poommyroboticcamera-netizen/DATA-Logging-Dashboard-esp32/README.md

# ESP32 Data Logging Dashboard · v2.0

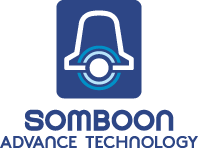
[picture p1: dashboard/assets/somboon-logo.png]
Somboon Advance Technology


แดชบอร์ดสำหรับดูค่าเซนเซอร์และบันทึกข้อมูลลง SD card/CSV ผ่าน ESP32 ใช้ Wi‑Fi 2.4 GHz เปิดดูจากโทรศัพท์หรือคอมพิวเตอร์ในเครือข่ายเดียวกันได้ หน้าเว็บฝังอยู่ในเฟิร์มแวร์: อัปโหลดครั้งเดียวได้ทั้งโปรแกรมและหน้าเว็บ

[ลองหน้าเว็บตัวอย่าง](https://poommyroboticcamera-netizen.github.io/DATA-Logging-Dashboard-esp32/) · [วิธีติดตั้ง](#เริ่มใช้งาน) · [วิธีบันทึกข้อมูล](#บันทึกข้อมูล) · [แก้ปัญหาเบื้องต้น](#แก้ปัญหาเบื้องต้น)

> **หน้าเว็บตัวอย่างบน GitHub Pages ใช้ข้อมูลจำลอง** ปุ่มต่าง ๆ ในหน้านั้นไม่สั่ง ESP32 จริง หากจะตั้งค่า Wi‑Fi หรือบันทึกจากบอร์ด ให้เปิดหน้าเว็บจาก IP ของ ESP32 หรือจุดตั้งค่า `192.168.4.1`

## มีอะไรใน v2.0

- ดู INA226 สามช่อง, DHT22, DS18B20 สี่ตัว, IMU, RTC, Encoder และสถานะการบันทึกแบบสด
- เริ่ม/หยุดบันทึกจากหน้าเว็บหรือปุ่มบนบอร์ด ตั้งช่วงบันทึกได้ **100–60,000 ms** (ค่าเริ่มต้น **1,000 ms**)
- บันทึก CSV ลง SD card ขณะกด START เท่านั้น; เมื่อกด STOP ระบบเขียนข้อมูลที่ค้างให้เสร็จและปิด SD
- ตั้ง Wi‑Fi ใหม่จากหน้าเว็บได้ แม้ยังต่อเราเตอร์เดิมไม่ได้ เพราะ ESP32 เปิดจุดตั้งค่า Wi‑Fi ของตัวเอง
- อ่านสัญญาณ **Z ของ Encoder ที่ GPIO33**; หน้าเว็บแสดง **WHEEL RPM (รอบล้อ)** ซึ่งคำนวณจากอัตราทดลูกกลิ้ง
- มีไฟ GA0–GA3 บอกสถานะการเขียน SD และมีบรรทัด `[ENC Z]` ทาง Serial สำหรับตรวจสาย Encoder

รุ่นก่อนหน้าอยู่ที่แท็ก [v1.0](https://github.com/poommyroboticcamera-netizen/DATA-Logging-Dashboard-esp32/tree/v1.0) ส่วนรุ่นนี้อยู่ที่ [v2.0](https://github.com/poommyroboticcamera-netizen/DATA-Logging-Dashboard-esp32/tree/v2.0) ทั้งสองรุ่นไม่มี CAN bus

## เริ่มใช้งาน

ต้องมีบอร์ด ESP32, สาย USB สำหรับอัปโหลด, [VS Code + PlatformIO](https://platformio.org/install/ide?install=vscode) หรือ PlatformIO CLI และการต่อเซนเซอร์ตาม [ตารางขา](#ขาและอุปกรณ์หลัก) หากจะบันทึกลง SD ให้ใส่การ์ด **FAT16/FAT32** ก่อนเริ่ม (exFAT ใช้ไม่ได้)

1. ดาวน์โหลดหรือโคลนโปรเจกต์ แล้วสร้างไฟล์ Wi‑Fi ส่วนตัวจากไฟล์ตัวอย่าง:

   ```powershell
   git clone https://github.com/poommyroboticcamera-netizen/DATA-Logging-Dashboard-esp32.git
   cd DATA-Logging-Dashboard-esp32
   Copy-Item include/wifi_config.example.h include/wifi_config.h
   ```

   บน macOS/Linux ใช้ `cp include/wifi_config.example.h include/wifi_config.h` แทน `Copy-Item` จะใส่ชื่อ/รหัส Wi‑Fi 2.4 GHz ใน `include/wifi_config.h` ตอนนี้ก็ได้ หรือปล่อยข้อความตัวอย่างไว้แล้วตั้งค่าผ่านจุดตั้งค่าของ ESP32 หลังอัปโหลด ไฟล์ `wifi_config.h` ถูก Git เพิกเฉยและไม่ควรพุชขึ้นสาธารณะ

2. ต่อบอร์ดผ่าน USB เลือกพอร์ตให้ถูก แล้วกด **Upload** ใน PlatformIO หรือใช้คำสั่ง:

   ```sh
   pio run -e esp32dev -t upload
   pio device monitor -b 115200
   ```

   ปิด Serial Monitor อื่นก่อนอัปโหลด หลังอัปโหลดไม่ต้องคัดลอกไฟล์ HTML ลง SD อีก

3. เปิดแดชบอร์ดด้วยวิธีใดวิธีหนึ่ง:

   - **ผ่านเราเตอร์:** ต่อโทรศัพท์/คอมกับ Wi‑Fi เดียวกัน แล้วเปิด IP ที่บอร์ดแสดงทาง Serial เช่น `http://192.168.1.50/`
   - **ผ่านจุดตั้งค่าของ ESP32:** ต่อ Wi‑Fi ชื่อ `ESP192.168.4.1` รหัส `88888888` แล้วเปิด `http://192.168.4.1/` หากบอร์ดต่อเราเตอร์ได้แล้ว ชื่อจุดตั้งค่าอาจเปลี่ยนเป็น `ESP` ตามด้วย IP ที่เราเตอร์แจก เช่น `ESP192.168.1.50`

4. ต้องการเปลี่ยนเราเตอร์ให้กดเมนู **ตั้งค่า Wi‑Fi** ใส่ SSID/รหัสผ่านของเครือข่าย **2.4 GHz** แล้วกด **บันทึกและเชื่อมต่อใหม่** บอร์ดจะรีสตาร์ต; หลังจากนั้นเปิด IP ใหม่หรือกลับเข้าผ่านจุดตั้งค่า

> เมื่อเชื่อมกับจุดตั้งค่าของ ESP32 โทรศัพท์อาจแจ้งว่า “ไม่มีอินเทอร์เน็ต” ให้คงการเชื่อมต่อนี้ไว้เพื่อเปิด `192.168.4.1` ถ้าหน้าเว็บหลังอัปโหลดดูเป็นรุ่นเก่า ให้รีเฟรชแบบไม่ใช้แคช (`Ctrl+F5`)

## บันทึกข้อมูล

1. ตรวจว่าหน้าเว็บแสดงค่าปัจจุบันและใส่ SD card แบบ FAT16/FAT32 แล้ว ตั้ง **ช่วงเวลาบันทึก** ตามต้องการ; ค่าเริ่มต้น 1,000 ms และบอร์ดจำค่าที่ตั้งไว้ (บอร์ดจะตรวจพบการ์ดจริงเมื่อกดเริ่มเท่านั้น)
2. กด **เริ่มบันทึก** บนเว็บหรือปุ่ม START บนบอร์ด บอร์ดจะสร้างรอบบันทึกใหม่และเริ่มเขียน CSV ลง SD
3. กด **หยุดบันทึก** บนเว็บหรือปุ่ม STOP รอให้บอร์ดเขียนแถวที่ค้างและปิด SD ก่อนถอดการ์ด
4. ไฟล์บน SD อยู่ในโฟลเดอร์ `/logs/` เช่น `log_00001.csv` ถ้าถอดการ์ดหลังปิด SD แล้วจึงนำไฟล์ไปเปิดบนคอมได้ หน้า **Logs** แสดงเฉพาะสำเนา CSV ที่เบราว์เซอร์เก็บไว้และให้ดาวน์โหลด/ลบสำเนานั้น ไม่ได้ลบไฟล์บน SD

เมื่อไม่ได้บันทึก บอร์ดยังแสดงค่าปัจจุบันแต่ไม่เปิดอ่าน/เขียน SD การตั้งช่วงเวลา 100 ms ไม่ได้ทำให้เซนเซอร์ทุกตัวอ่านใหม่ทุก 100 ms; ค่าใดอัปเดตช้ากว่าจะใช้ค่าล่าสุดพร้อมตัวบอกอายุข้อมูล

### ไฟ GA0–GA3 หมายถึงอะไร

| สถานะ | ไฟ GA |
|---|---|
| ระบบเริ่มต้น หรือเริ่มบันทึกแต่ SD ยังไม่เขียนแถวแรก | ติดทั้ง 4 ดวง |
| SD เขียนแถวแรกสำเร็จและกำลังบันทึก | ไฟวิ่ง GA3 → GA0 ตามช่วงเวลาบันทึก |
| กดหยุดและกำลังรอ SD ปิด | ติดทั้ง 4 ดวง |
| หยุดบันทึกและ SD ปิดเรียบร้อย | ดับทั้ง 4 ดวง |
| SD เขียนผิดพลาด หรือหลังรีเซตที่ไม่ใช่การเปิดไฟใหม่ | ติดทั้ง 4 ดวงเพื่อเตือน |

ไฟเตือนต้องอาศัย MCP23017 และไฟเลี้ยงของมัน หากอุปกรณ์นี้หรือ I²C ใช้งานไม่ได้ ระบบไม่สามารถรับประกันสถานะไฟได้

## เข้าใจค่า Encoder และ CSV

- สายสัญญาณ **Z → GPIO33**, GND ต้องร่วมกัน และสัญญาณที่เข้าขา ESP32 ต้องไม่เกิน **3.3 V** ถ้า Encoder ส่ง 5 V ต้องแปลงระดับก่อน
- ค่าเริ่มต้นสมมติว่า Z ให้ **1 พัลส์ต่อ 1 รอบ Encoder** โปรดตรวจสเปก Encoder ของจริง ระบบไม่อ่าน A/B จึงไม่รู้ทิศหมุน
- ลูกกลิ้ง Encoder เส้นผ่านศูนย์กลาง **43 mm** สัมผัสล้อ **63 mm** ดังนั้น `RPM ล้อ = RPM Encoder × 43/63` เมื่อไม่ลื่น การ์ด **WHEEL RPM** บนเว็บใช้ค่านี้ ไม่ใช่ค่า PWM ของมอเตอร์
- ใน CSV คอลัมน์ `RPMencoder` และ `shaft_rpm` คือรอบแกน Encoder; `wheel_rpm` คือรอบล้อที่คำนวณแล้ว หากลูกกลิ้งลื่น ตัวเลขรอบล้อ/ความเร็วจะคลาดเคลื่อน
- INA226: **Battery 0x44 → Vbat/Ibat**, **Rotary 0x45 → Vrotary/Irotary**, **Camera 0x40 → Vcamera/Icamera**; `Iwheel = Ibat - Irotary - Icamera` ค่าเริ่มต้น Rshunt ของแต่ละช่องคือ 1 mΩ และควรตั้งให้ตรงกับฮาร์ดแวร์จริง
- ไฟล์ CSV ยังมีเวลา RTC, อุณหภูมิ, IMU, สถานะความถูกต้อง/อายุข้อมูลของเซนเซอร์, จำนวนพัลส์ และช่วงเวลาบันทึก เริ่มไฟล์ใหม่ `sequence` จะเริ่มนับใหม่

สัญญาณ Z ที่ 1 พัลส์/รอบของลูกกลิ้ง 43 mm มีระยะประมาณ 135 mm ต่อพัลส์ จึงเหมาะกับการอ่านรอบมากกว่าระยะทางละเอียด และต้องได้อย่างน้อยสองพัลส์ก่อนประมาณ RPM ครั้งแรก

## ขาและอุปกรณ์หลัก

| อุปกรณ์ | ขา ESP32 / I²C |
|---|---|
| I²C SDA / SCL | GPIO21 / GPIO22 |
| INA226 Camera / Rotary / Battery | `0x40` / `0x45` / `0x44` |
| IMU MPU6050/MPU6500 · RTC MCP7940N · MCP23017 | `0x68` หรือ `0x69` · `0x6F` · `0x27` |
| Encoder Z | GPIO33 |
| DHT22 | GPIO4 |
| DS18B20 1–4 | GPIO27 / 16 / 13 / 14 (สาย DATA แยกกัน) |
| SD CS / SCK / MISO / MOSI | GPIO5 / 18 / 19 / 23 |
| ปุ่ม START / STOP | GPIO36 / GPIO39, active LOW, ต้องมี pull-up ภายนอก |
| ไฟ Debug | GPIO2 |

ตรวจ [เอกสารฮาร์ดแวร์](hardware/README.md) และลายวงจรของบอร์ดจริงก่อนต่อไฟ รุ่น schematic เก่าบางฉบับระบุ START เป็น GPIO34 แต่ค่าเริ่มต้นเฟิร์มแวร์ v2.0 ใช้ GPIO36

## แก้ปัญหาเบื้องต้น

| อาการ | จุดที่ควรตรวจ |
|---|---|
| ไม่พบ Wi‑Fi ของ ESP32 | ตรวจว่าอัปโหลด v2.0 แล้ว, ไฟเลี้ยงและ Serial 115200; ชื่อ AP อาจเปลี่ยนจาก `ESP192.168.4.1` เป็น `ESP` ตามด้วย IP ของบอร์ด |
| กดบันทึก Wi‑Fi ไม่ได้ | ต้องเปิดหน้าเว็บที่ ESP32 เสิร์ฟ ไม่ใช่หน้าเดโมบน GitHub หรือไฟล์ `tmp/dashboard-redesign.html` |
| Encoder เป็น `—` หรือไม่เพิ่มพัลส์ | ตรวจ Z ที่ GPIO33, GND ร่วม, ระดับ 3.3 V, เปิดอ่าน Encoder; ดูบรรทัด `[ENC Z]` ทาง Serial ค่า `total` ควรเพิ่มเมื่อหมุน |
| รอบล้อไม่ตรงจริง | ตรวจพัลส์ Z ต่อรอบ, อัตราทด 63/43, ขนาดล้อจริง และการลื่นของลูกกลิ้ง |
| SD ไม่มีไฟล์/ไฟ GA ติดค้าง | ตรวจการ์ด FAT16/FAT32, สาย SPI, `sd_status`/`sd_written`; อย่าถอดการ์ดก่อน STOP ปิด SD เสร็จ |
| บอร์ดรีเซตเอง | อ่านสาเหตุที่ `/api/health` และดู [คู่มือแก้ปัญหา](docs/troubleshooting.md) |

## สำหรับผู้พัฒนา

```sh
node dashboard/core.test.cjs
node dashboard/imu-model.test.cjs
node scripts/test_ga_demo.cjs
python scripts/test_firmware_csv.py
pio run -e esp32dev
```

`src/main.cpp` คือเฟิร์มแวร์, `dashboard/` คือหน้าเว็บที่ฝังในโปรแกรม, `scripts/build_dashboard_demo.py` สร้างหน้าเดโม, `hardware/` เก็บเอกสารวงจรและ PCB ดูรายละเอียด API/การบันทึกที่ [dashboard/README.md](dashboard/README.md)

> **ความปลอดภัย:** จุดตั้งค่าใช้รหัสเริ่มต้นที่ระบุข้างต้น และ HTTP บนบอร์ดไม่มีระบบล็อกอิน ควรใช้ในเครือข่ายที่เชื่อถือได้เท่านั้น ไม่เปิดพอร์ตบอร์ดตรงสู่อินเทอร์เน็ต หากใช้กับอุปกรณ์จริง ให้ทดสอบความแม่นยำและความทนทานบนฮาร์ดแวร์ก่อนใช้งานต่อเนื่อง
