poommyroboticcamera-netizen/DATA-Logging-Dashboard-esp32/include/README

Configuration headers

Copy wifi_config.example.h to wifi_config.h for local credentials.
runtime_config.h contains board defaults. dashboard_page.h is generated during build.
