poommyroboticcamera-netizen/DATA-Logging-Dashboard-esp32/hardware/3d/exports/README.md

# 3d/exports

Neutral mechanical exchange files for enclosure, clearance, and assembly checks.

## Files

- [`dashboard-pcb-assembly-2026-09-08.step`](dashboard-pcb-assembly-2026-09-08.step) - EasyEDA/Open CASCADE AP214 assembly model.

Confirm units and critical connector or mounting dimensions in the receiving CAD tool before using the model for enclosure production.
