poommyroboticcamera-netizen/DATA-Logging-Dashboard-esp32/hardware/3d/previews/README.md

# 3d/previews

Rendered previews of the PCB assembly. These images are design renders rather than photographs of manufactured hardware.

## Files

ESP32 Data Logging Dashboard PCB

- [`dashboard-pcb-assembly-2026-09-08.png`](dashboard-pcb-assembly-2026-09-08.png) - Top-side assembly preview corresponding to the STEP model dated 2026-09-08.
