poommyroboticcamera-netizen/DATA-Logging-Dashboard-esp32/hardware/pcb/exports/README.md

# pcb/exports

Reviewable PCB layout exports for documentation and design inspection.

## Files

- [`dashboard-pcb-layout-2026-09-09.pdf`](dashboard-pcb-layout-2026-09-09.pdf) - Five-page EasyEDA PCB export showing component placement, routed layers, bottom artwork, and drill/pad information.

The original EasyEDA PDF contained 428 JavaScript link annotations. The repository copy removes those actions while preserving the visible pages. This export is not a Gerber or manufacturing release.
