poommyroboticcamera-netizen/DATA-Logging-Dashboard-esp32/hardware/schematic/exports/README.md

# schematic/exports

Reviewable schematic exports matching the PCB and firmware revision.

## Files

- [`dashboard-schematic-2026-09-09.pdf`](dashboard-schematic-2026-09-09.pdf) - Five-page EasyEDA schematic export covering the system overview, ESP32 and peripheral connections, power conversion, MCP23017 outputs, and three INA226 channels.

The editable EasyEDA source is not included yet. Verify net labels and firmware GPIO assignments against the assembled PCB before making hardware changes.
