poommyroboticcamera-netizen/DATA-Logging-Dashboard-esp32/hardware/3d/source/README.md

# 3d/source

Native CAD files; document application version and units.

Reserved for future design assets.
