poommyroboticcamera-netizen/DATA-Logging-Dashboard-esp32/hardware/pcb/source/README.md

# pcb/source

Editable PCB layout and required footprints.

Reserved for future design assets.
