poommyroboticcamera-netizen/DATA-Logging-Dashboard-esp32/hardware/schematic/source/README.md

# schematic/source

Editable schematic source and required libraries.

Reserved for future design assets.
