poommyroboticcamera-netizen/DATA-Logging-Dashboard-esp32/docs/assets/dashboard-preview.jpg

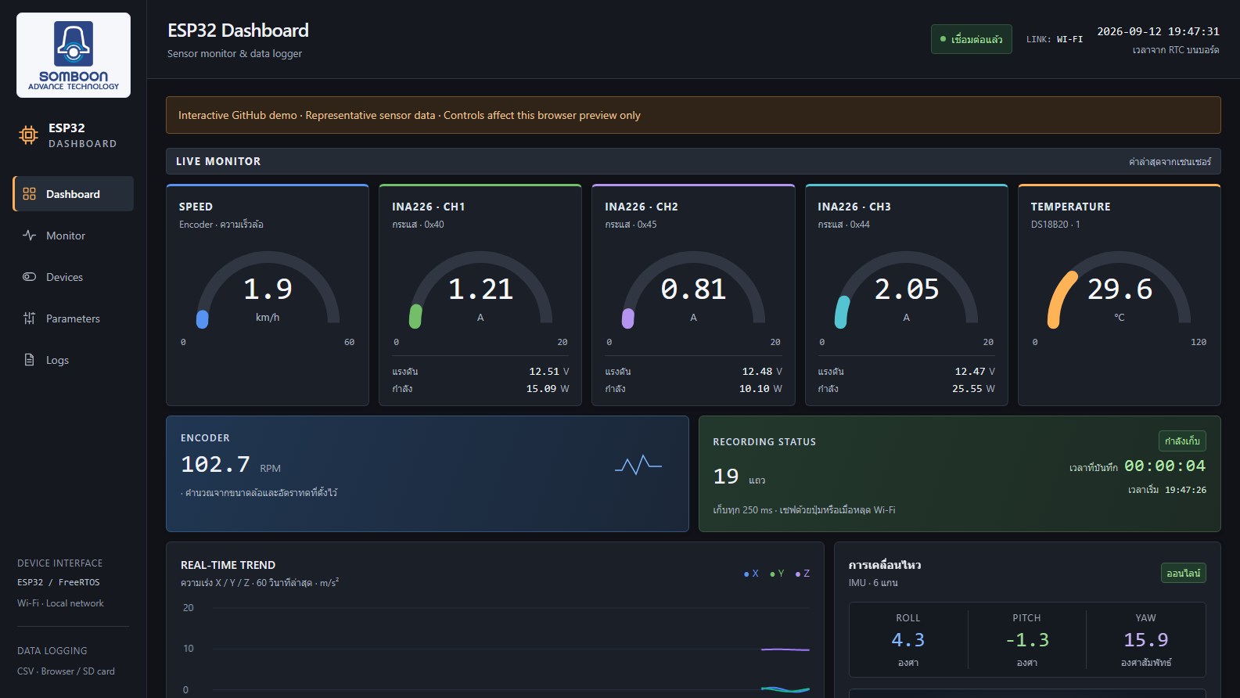
docs/assets/dashboard-preview.jpg
