poommyroboticcamera-netizen/DATA-Logging-Dashboard-esp32/hardware/pcb/manufacturing/README.md

# pcb/manufacturing

Gerber, drill, BOM and pick-and-place grouped by revision. No released production files yet.

Reserved for future design assets.
