poommyroboticcamera-netizen/DATA-Logging-Dashboard-esp32/hardware/schematic/exports/dashboard-schematic-2026-09-09.pdf

# INA226 SDA

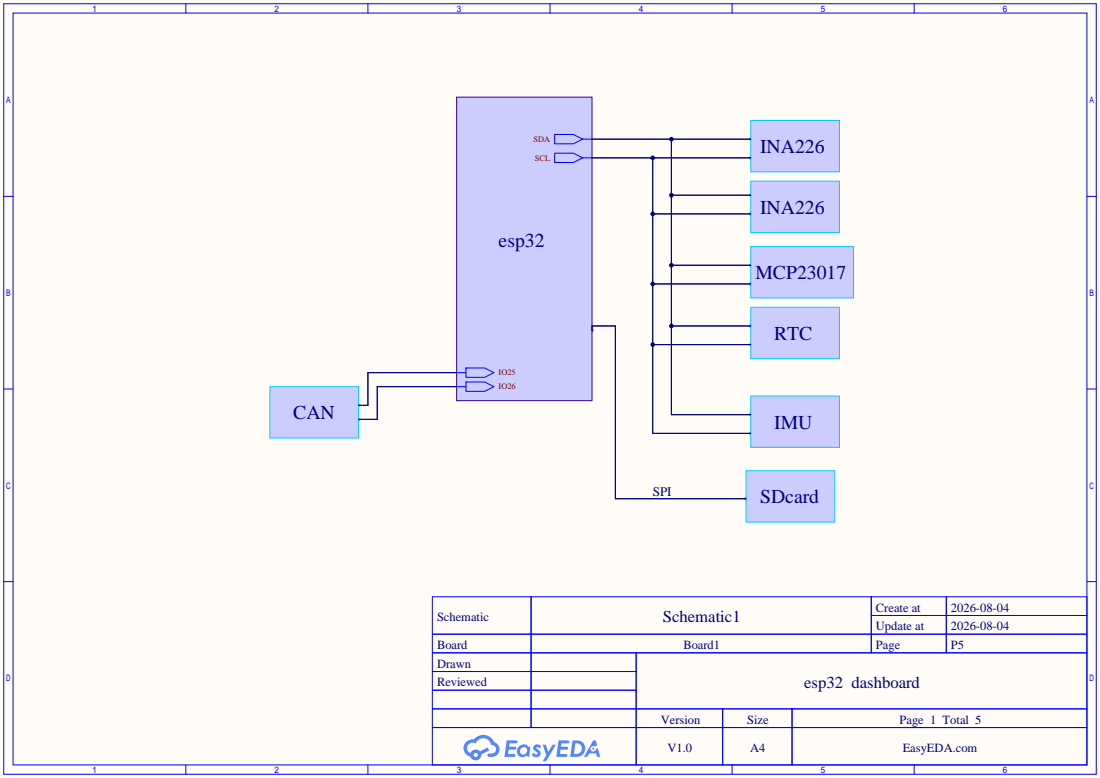
[picture p4: page 1]

Schematic | Schematic1 | Create at | 2026-08-04

Update at | 2026-08-04

Board | Board1 | Page | P5
Drawn | | esp32 dashboard
Reviewed

Version | Size | Page 1 Total 5

V1.0 | A4 | EasyEDA.com

# ESP32 38Pin Header RTC

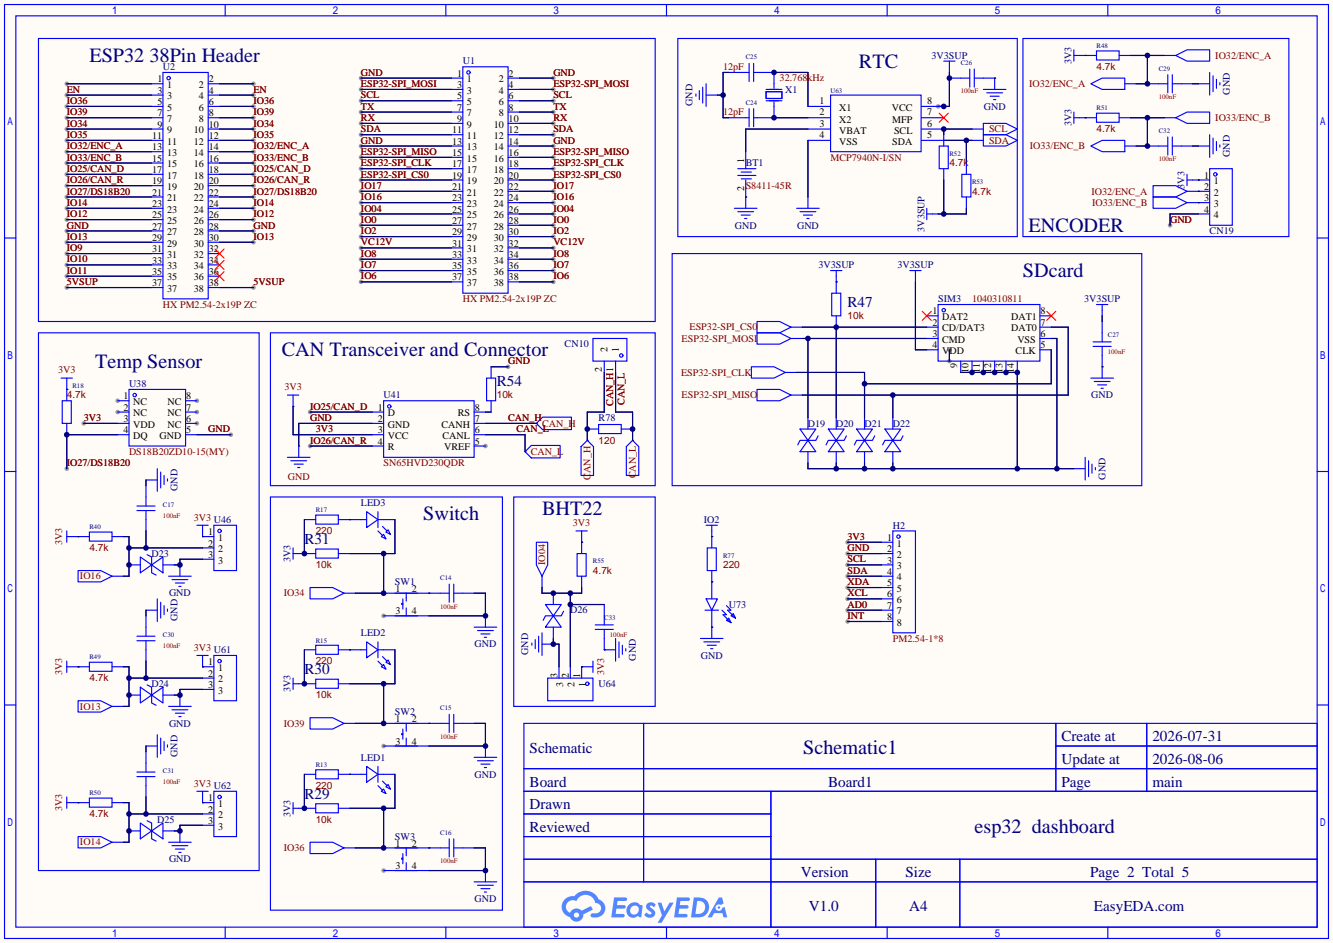
[picture p5: page 2]

CN10 CAN Transceiver and Connector

Schematic | Schematic1 | Create at | 2026-07-31

Update at | 2026-08-06

Board | Board1 | Page | main
Drawn | | esp32 dashboard
Reviewed

# Switching Regulator

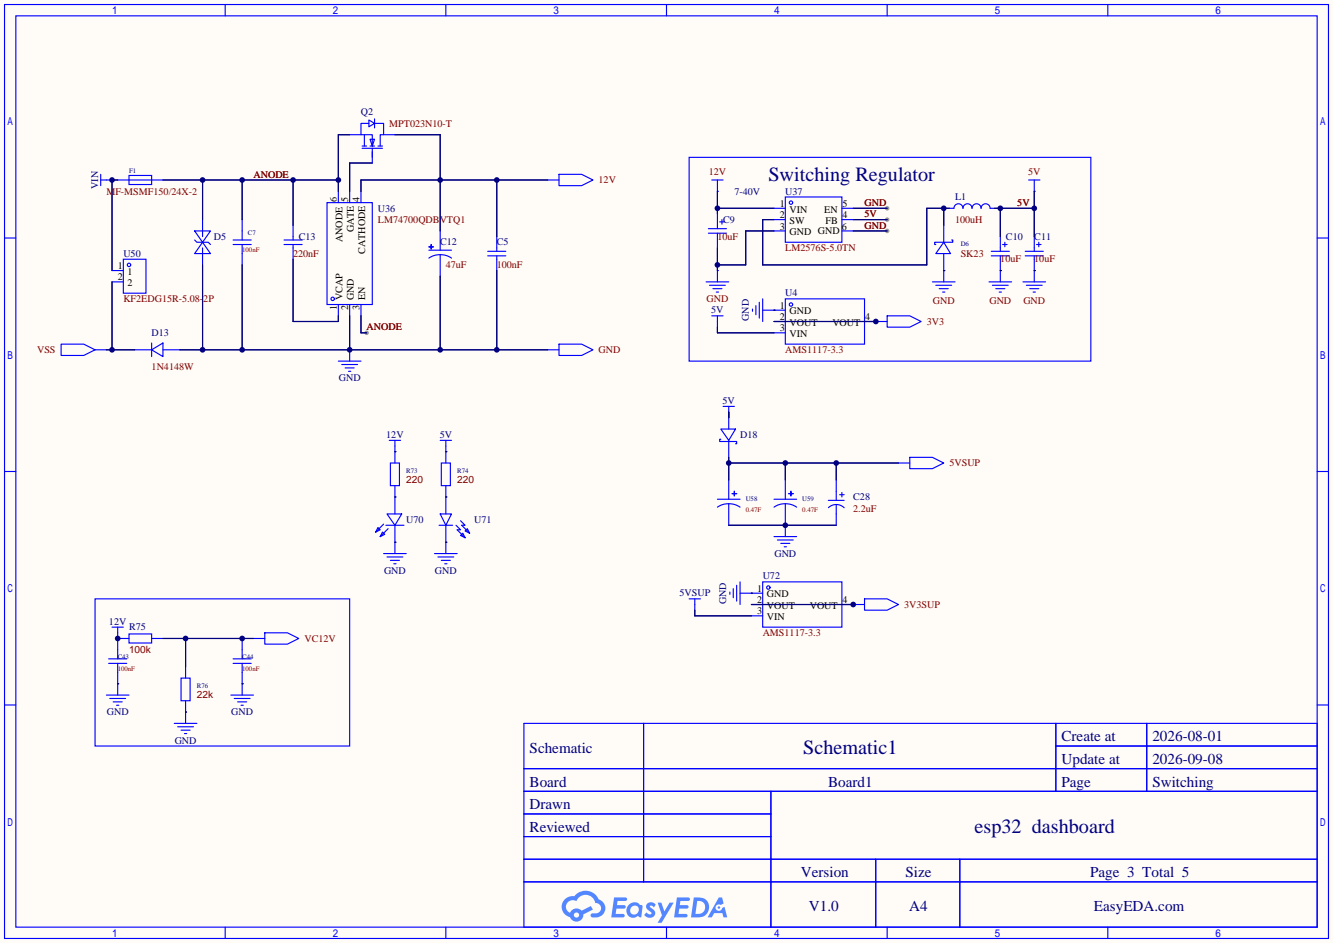
[picture p6: page 3]

Schematic | Schematic1 | Create at | 2026-08-01

Update at | 2026-09-08

Board | Board1 | Page | Switching
Drawn | | esp32 dashboard
Reviewed

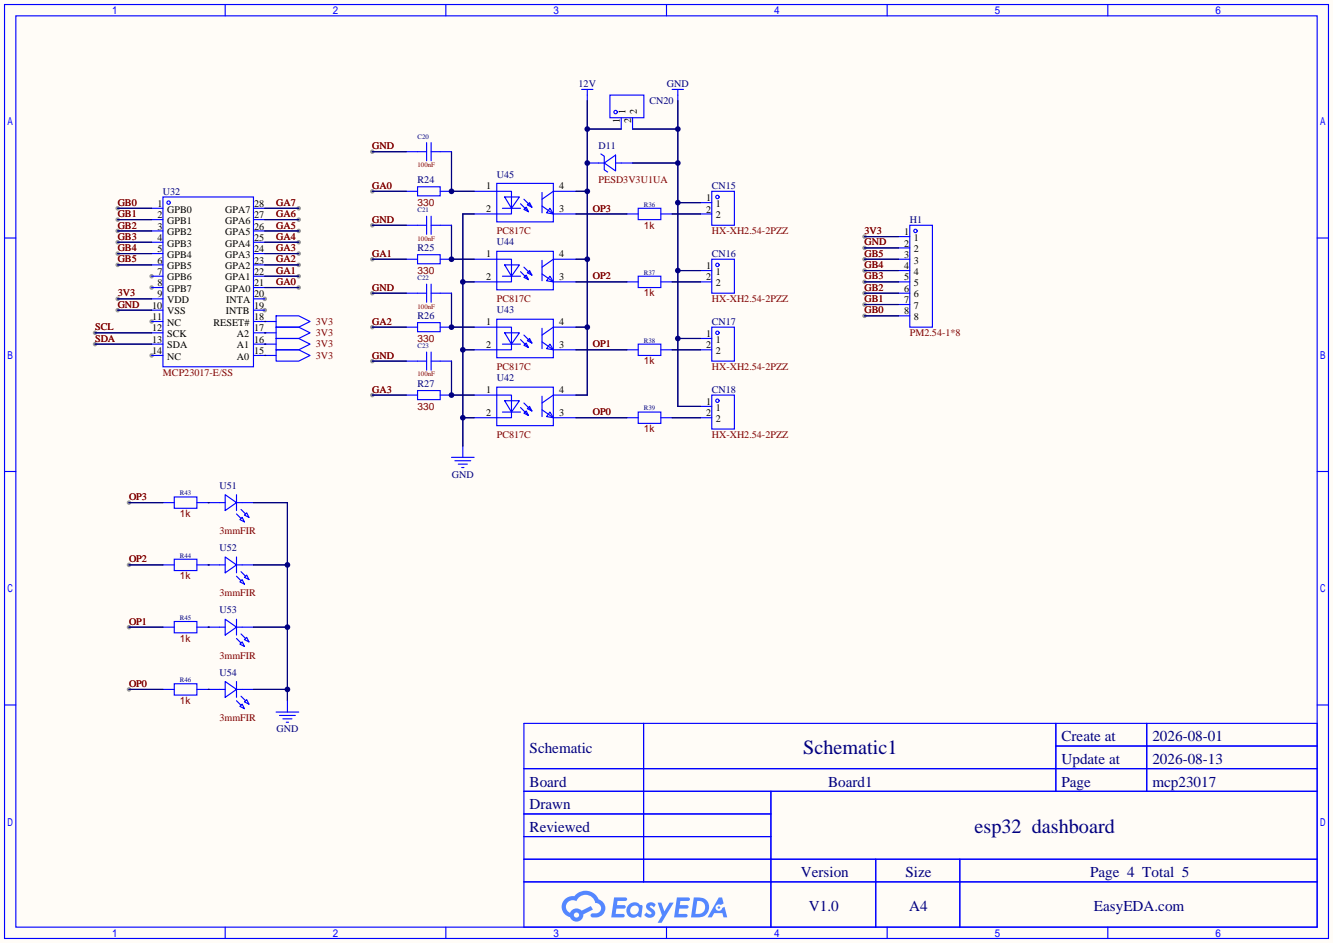
[picture p7: page 4]

Schematic | Schematic1 | Create at | 2026-08-01

Update at | 2026-08-13

Board | Board1 | Page | mcp23017
Drawn | | esp32 dashboard
Reviewed

## Address 0x40

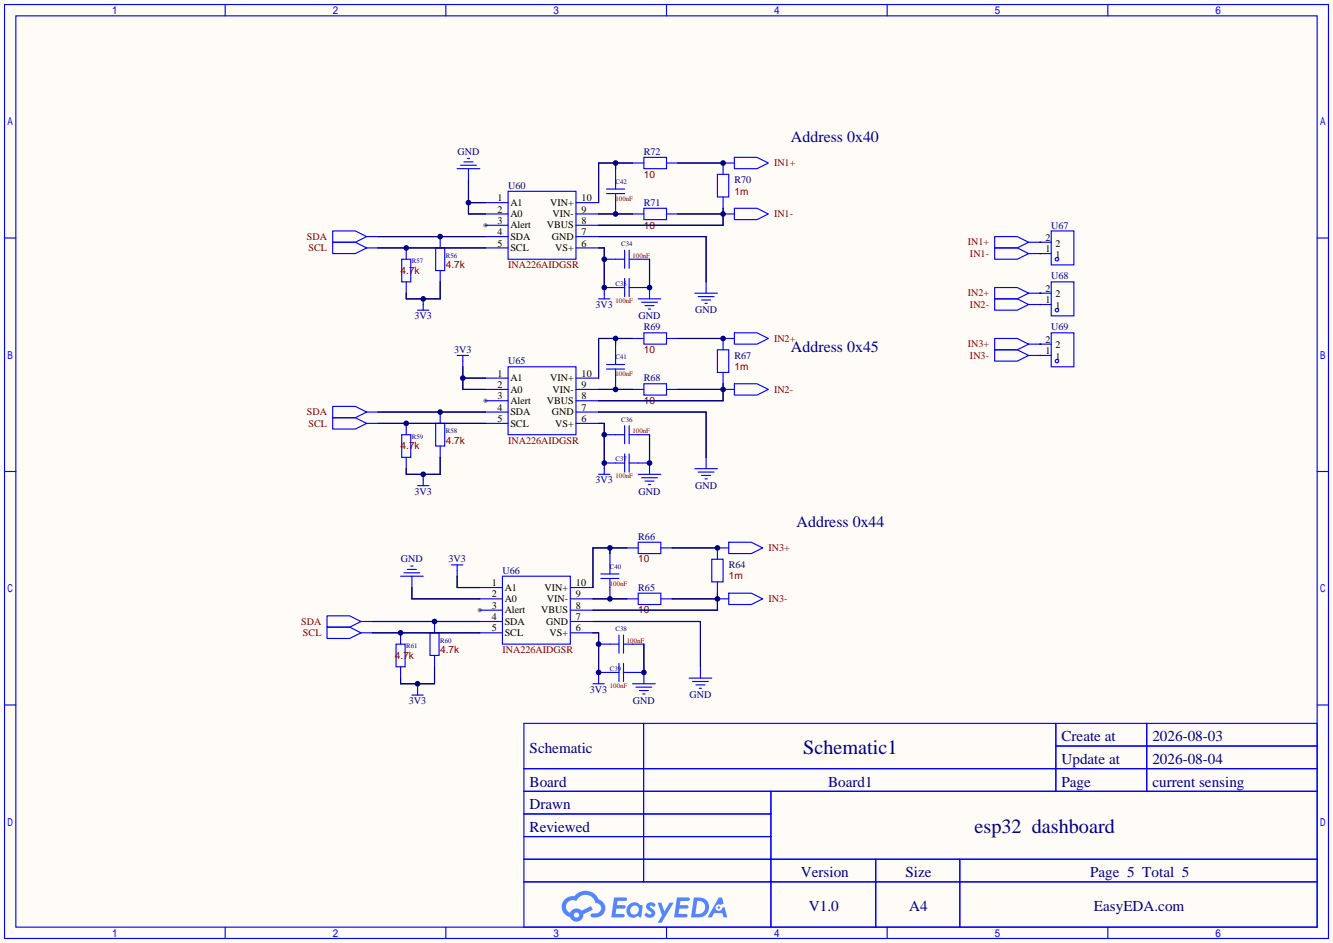
[picture p8: page 5]

Schematic | Schematic1 | Create at | 2026-08-03

Update at | 2026-08-04

Board | Board1 | Page | current sensing
Drawn | | esp32 dashboard
Reviewed
