poommyroboticcamera-netizen/DATA-Logging-Dashboard-esp32/hardware/pcb/exports/dashboard-pcb-layout-2026-09-09.pdf

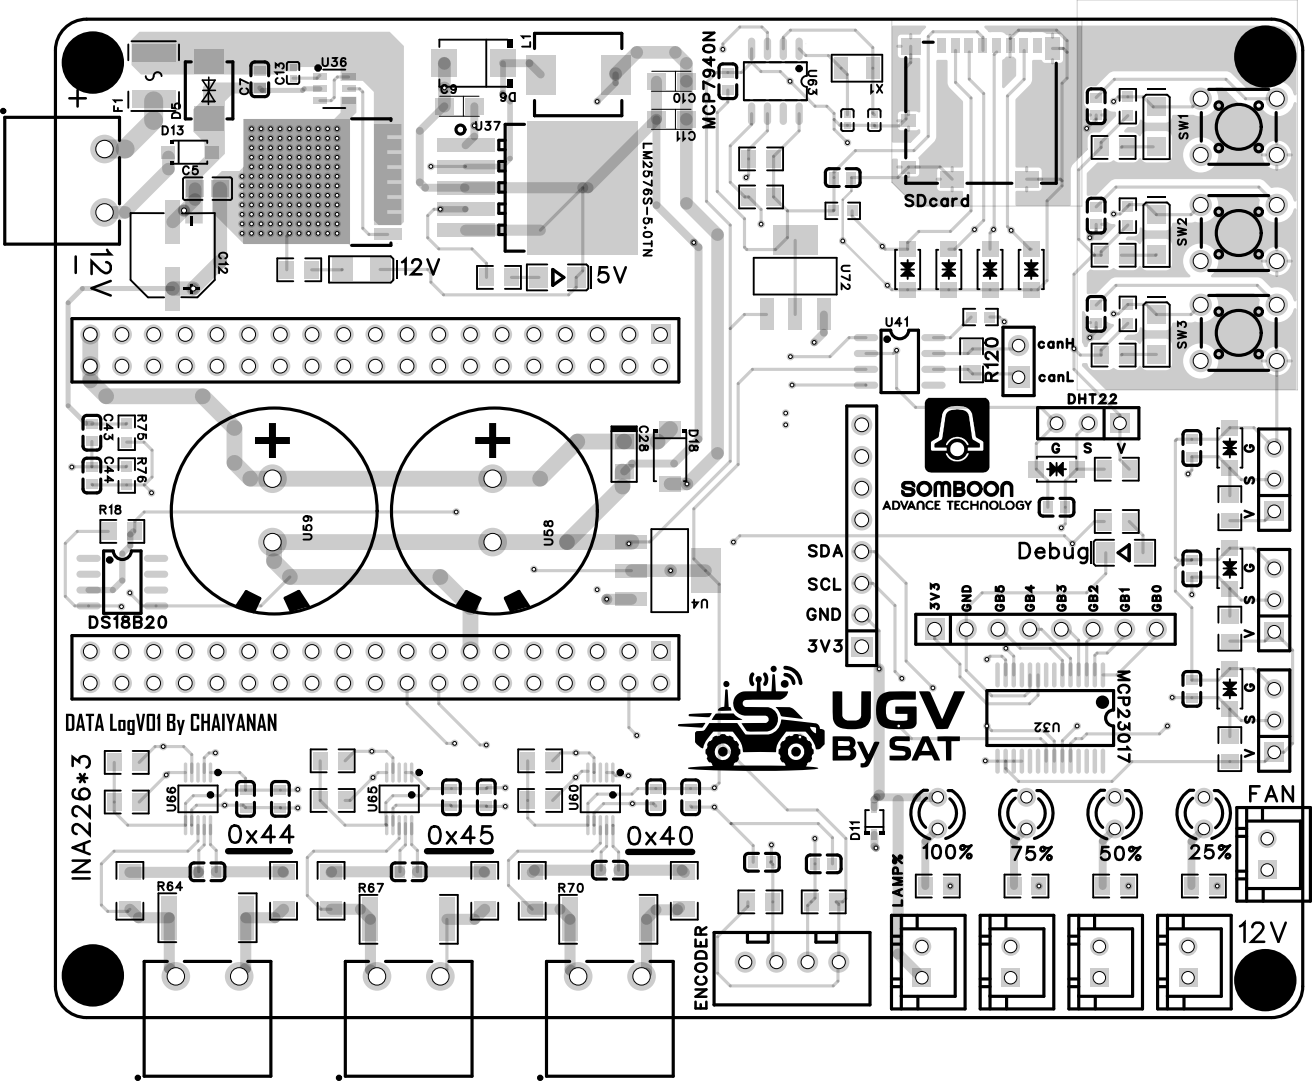
[picture p9: page 1]

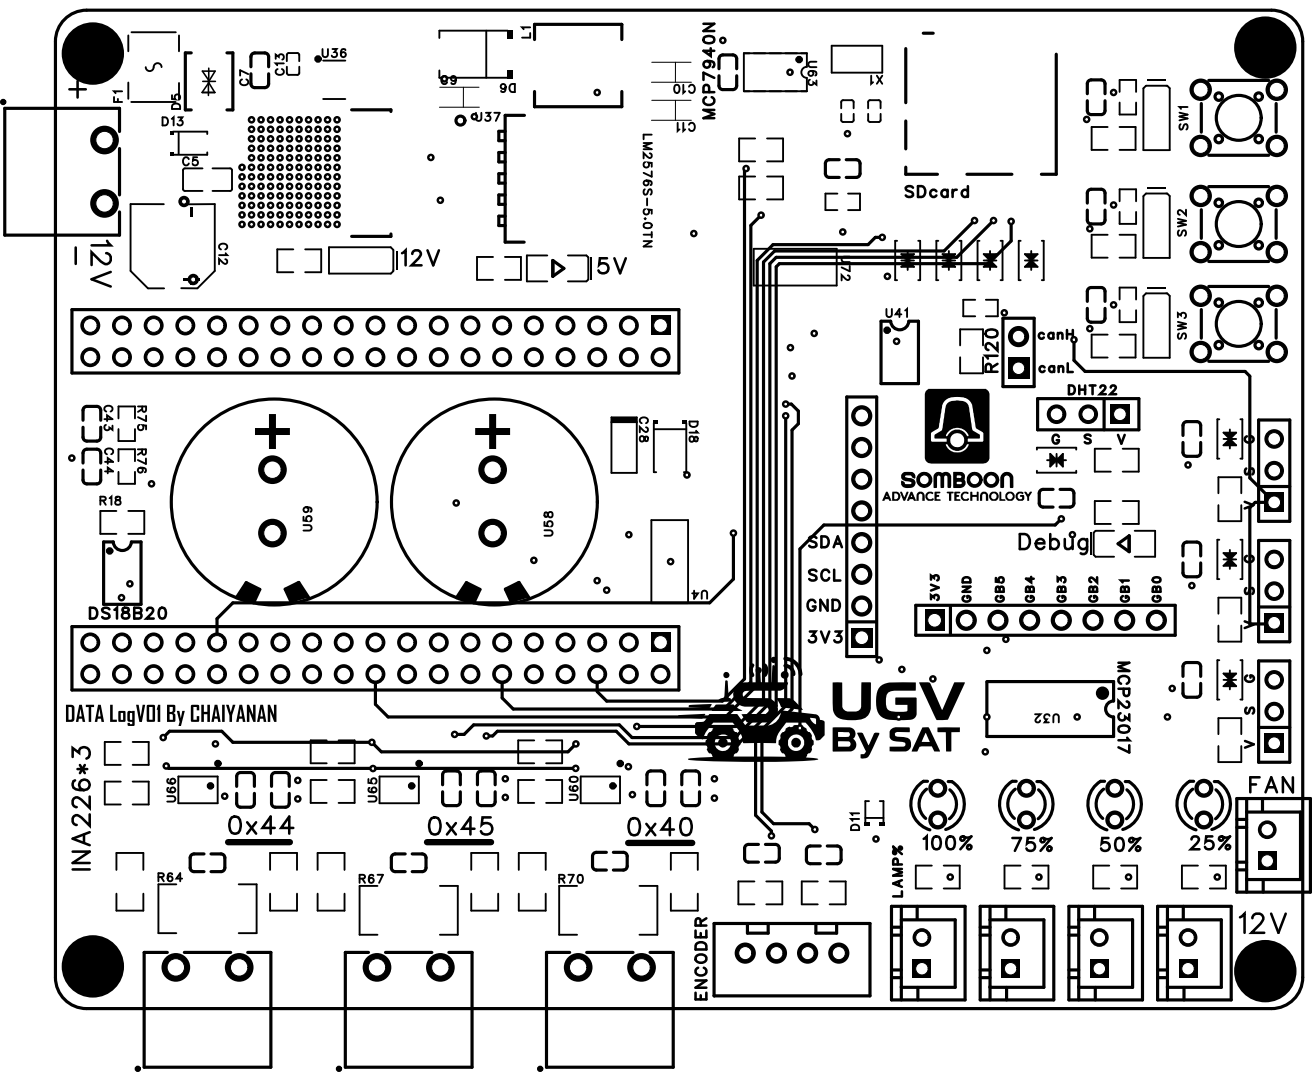
[picture p10: page 2]

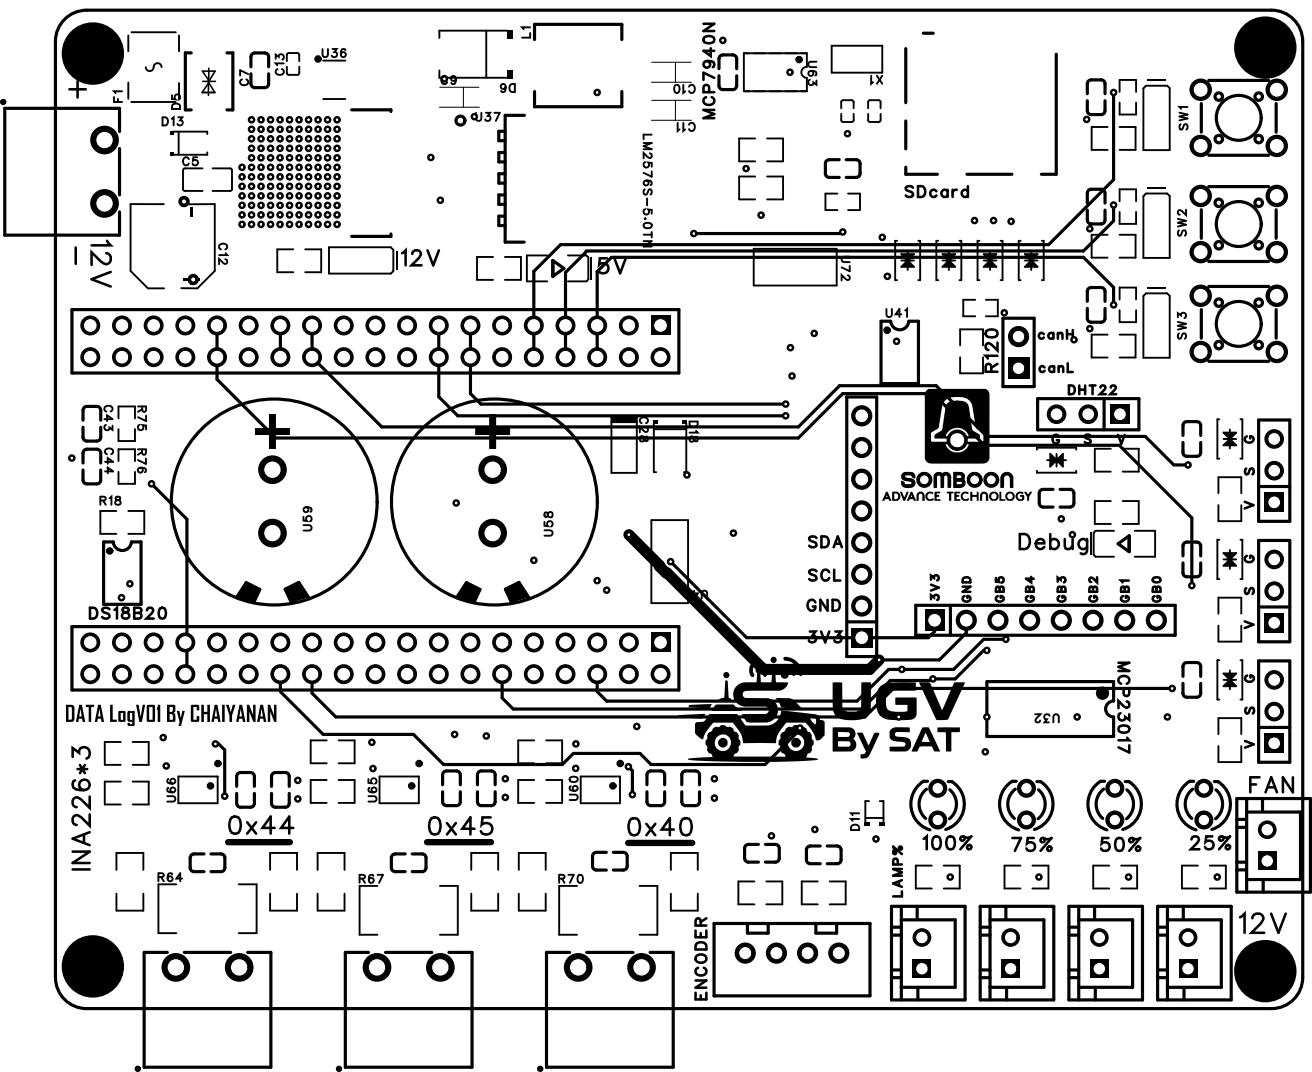
[picture p11: page 3]

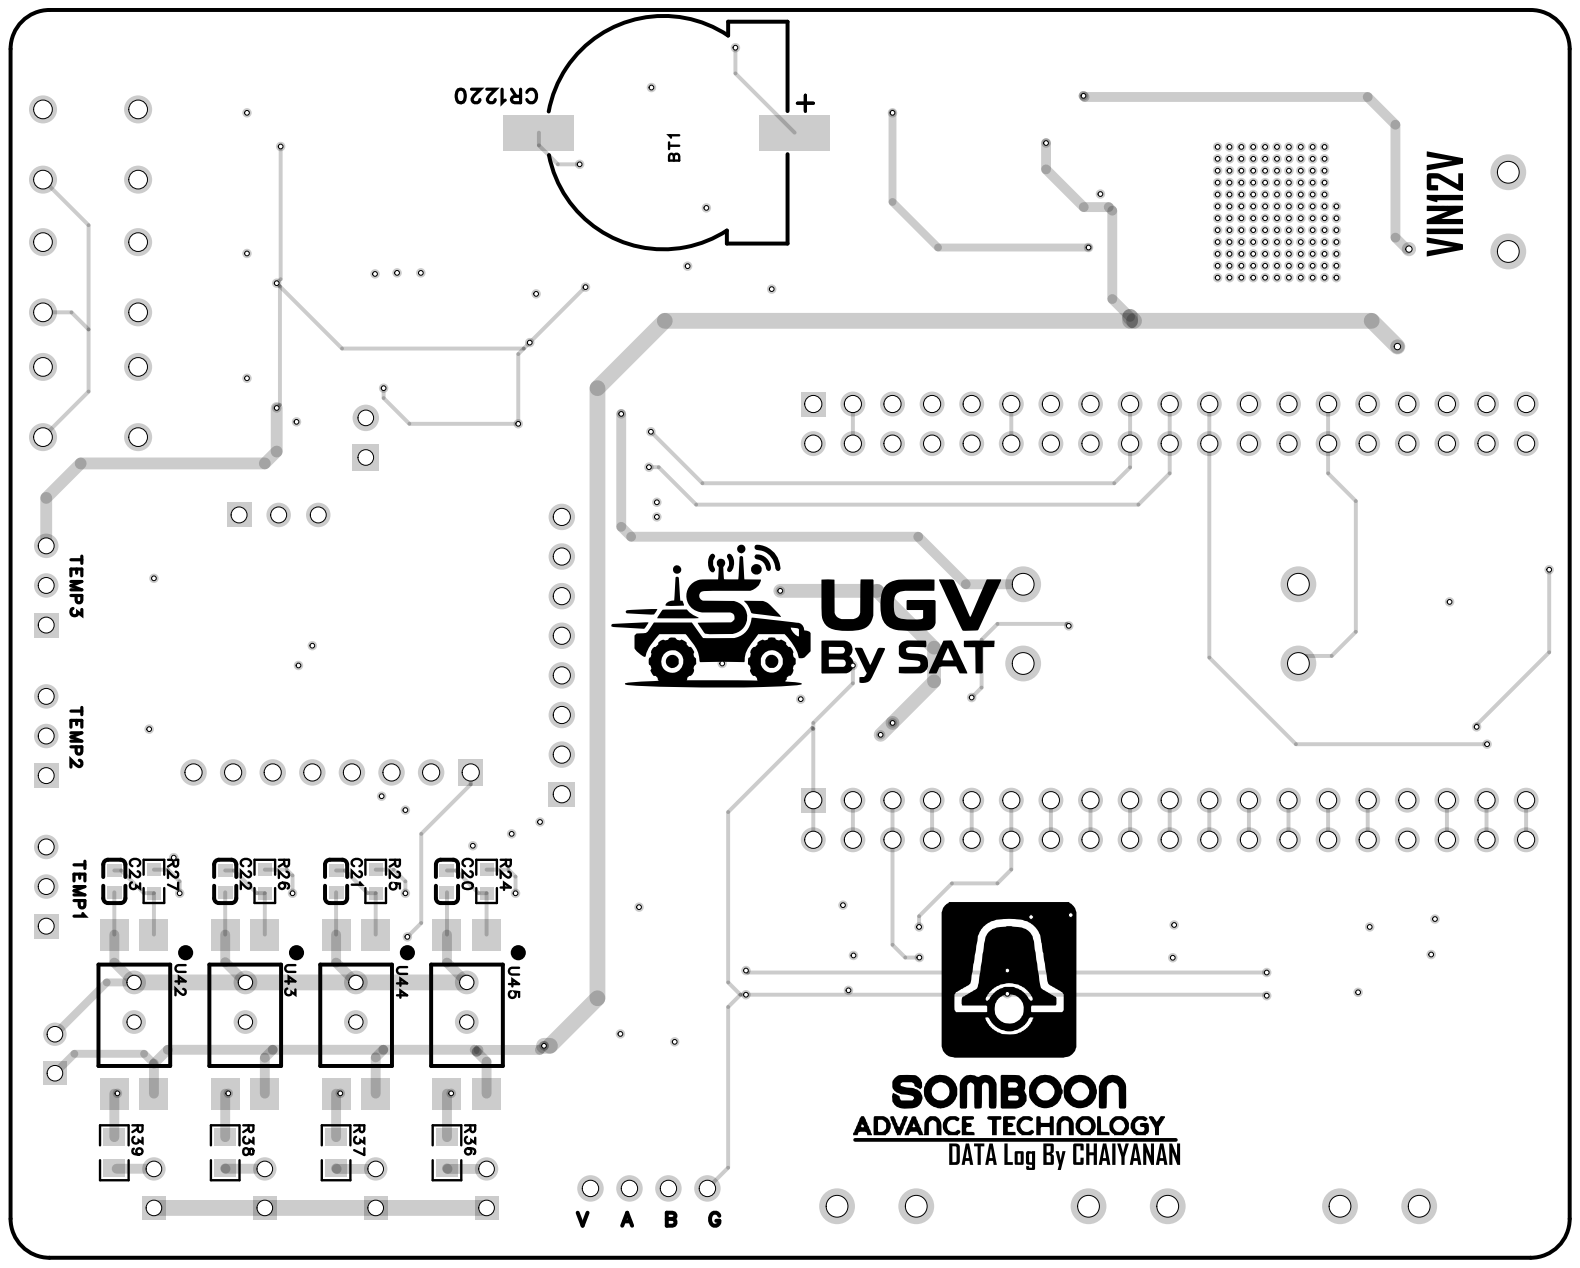
[picture p12: page 4]

DATA Log By CHAIYANAN

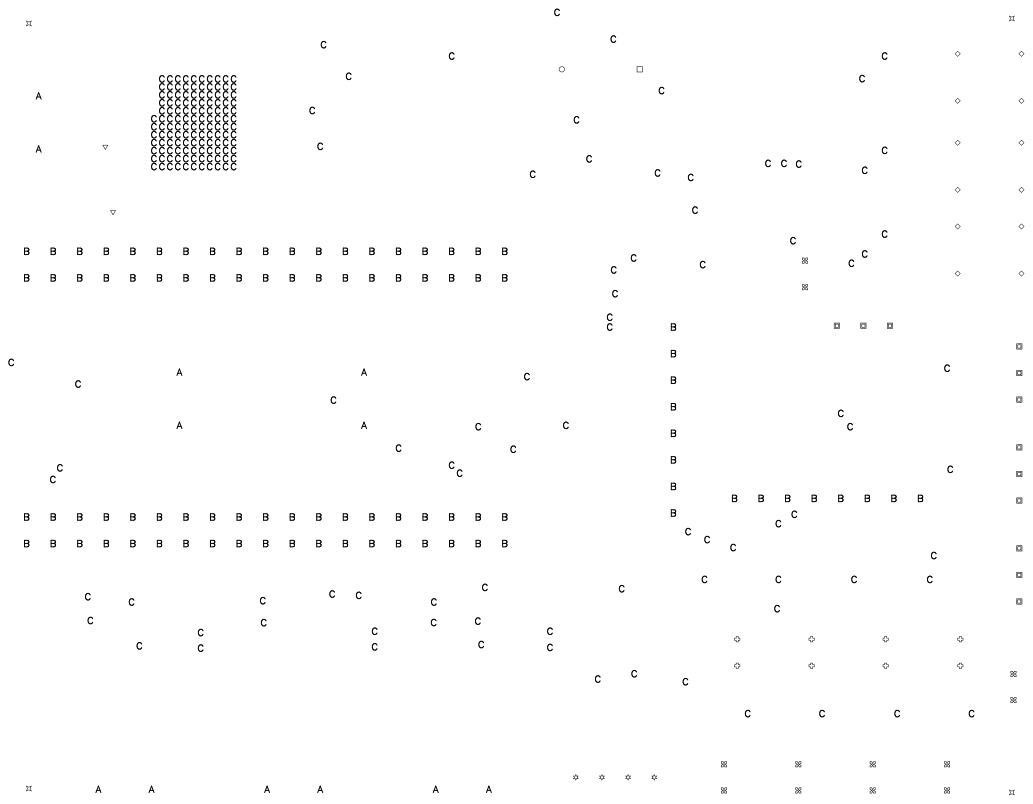
[picture p13: page 5]
