poommyroboticcamera-netizen/DATA-Logging-Dashboard-esp32/include/wifi_config.example.h

#pragma once
// Copy to wifi_config.h and enter a 2.4 GHz network. Never commit wifi_config.h.
constexpr const char *WIFI_SSID = "YOUR_WIFI_SSID";
constexpr const char *WIFI_PASSWORD = "YOUR_WIFI_PASSWORD";
constexpr bool SERIAL_IP_ONLY = true;
