poommyroboticcamera-netizen/DATA-Logging-Dashboard-esp32/(commit log)

2026-09-09 Add ESP32 dashboard firmware, documentation and hardware asset structure
2026-09-09 Add schematic, PCB, and 3D hardware design assets
2026-09-10 Fix yaw calibration progress and enable partial attitude reference
    [main.cpp]
2026-09-10 Refresh dashboard branding and robot preview with buffered IMU animation
2026-09-10 Compact recording timer beside row count
2026-09-12 เวอร์ชั่นพร้อมใช้งาน ไม่มี CAN bus
2026-09-12 ปรับระบบบันทึกและคาลิเบรต IMU
2026-09-14 Add web recording controls and 61-column sensor CSV
2026-10-16 Reorder INA gauges as battery rotary camera
